Anant713/Antenna-Deployment-System/Mod4_1.step

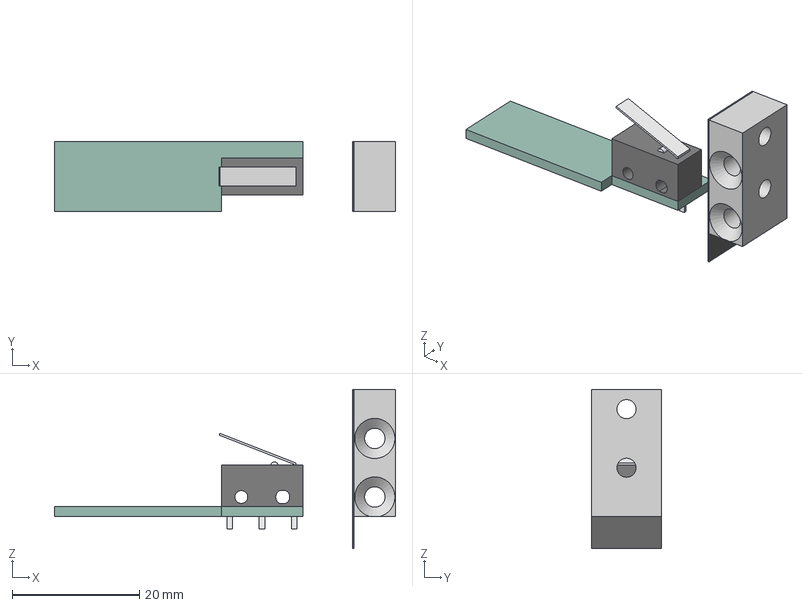
[picture p1: CAD file, 2026-06-16]
Mod4_1.step
53.6 x 11.0 x 25.0 mm
Mod4p3
Copperfoil^Mod4
d2f-01l
Part1^Mod4
