Anant713/Antenna-Deployment-System/Resistor_board/.step

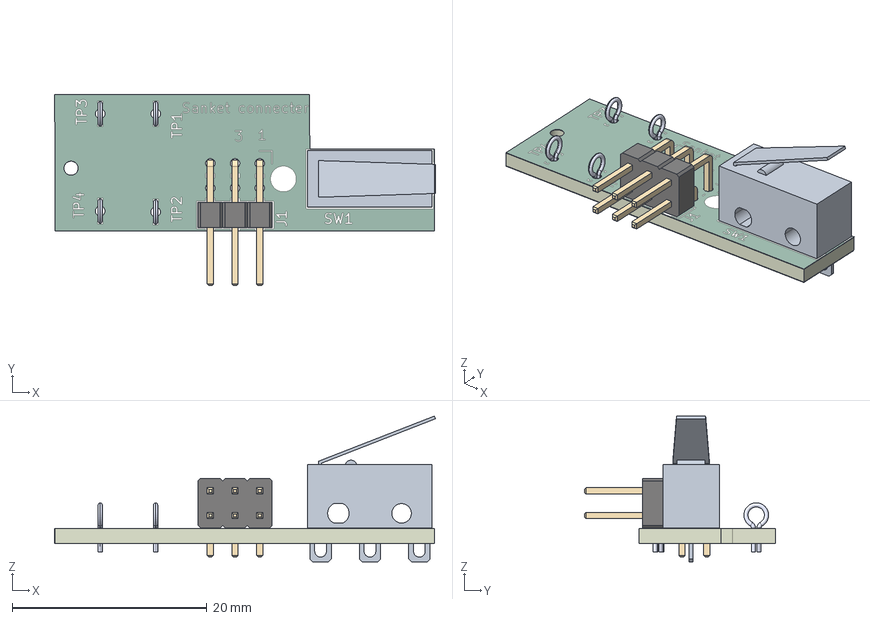
[picture p2: CAD file, 2026-05-25]
Resistor_board/.step
39.2 x 19.7 x 15.0 mm
D2F_01FL_D3.BASE
D2F_01FL_D3.ACTUATOR
PinHeader_2x03_P254mm_Horizontal
Resistor_board_silkscreen x 2
Resistor_board_soldermask x 2
Resistor_board_PCB
