Anant713/Antenna-Deployment-System/Resistor_board_nichrome/resistor_board_nichrome.step

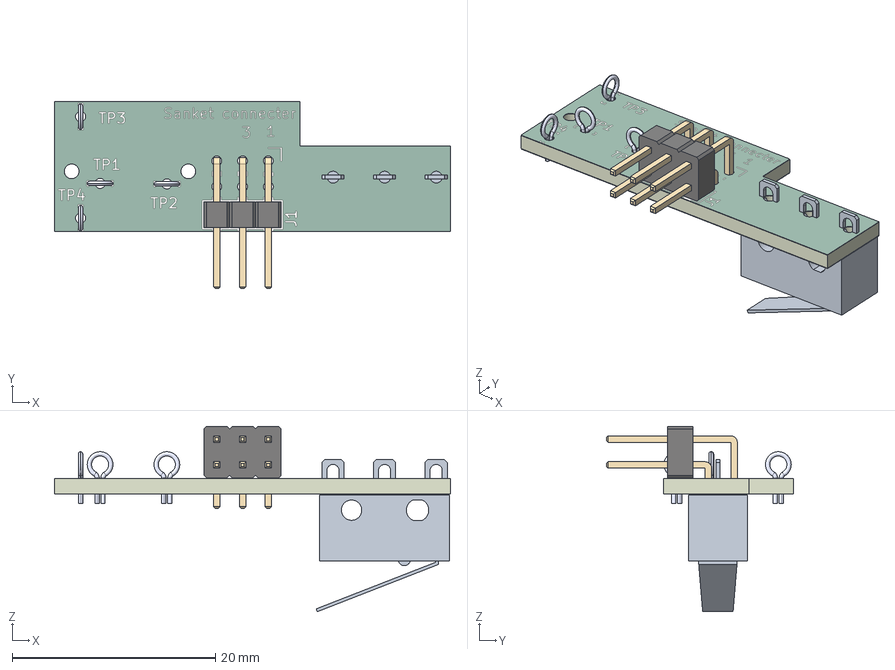
[picture p3: CAD file, 2026-06-17]
Resistor_board_nichrome/resistor_board_nichrome.step
39.0 x 18.4 x 18.3 mm
PinHeader_2x03_P254mm_Horizontal
D2F_01FL_D3.BASE
D2F_01FL_D3.ACTUATOR
Resistor_board_silkscreen x 2
Resistor_board_soldermask x 2
Resistor_board_PCB
