Anant713/Antenna-Deployment-System/Sanket_Deployment_board/ADS_V8.step

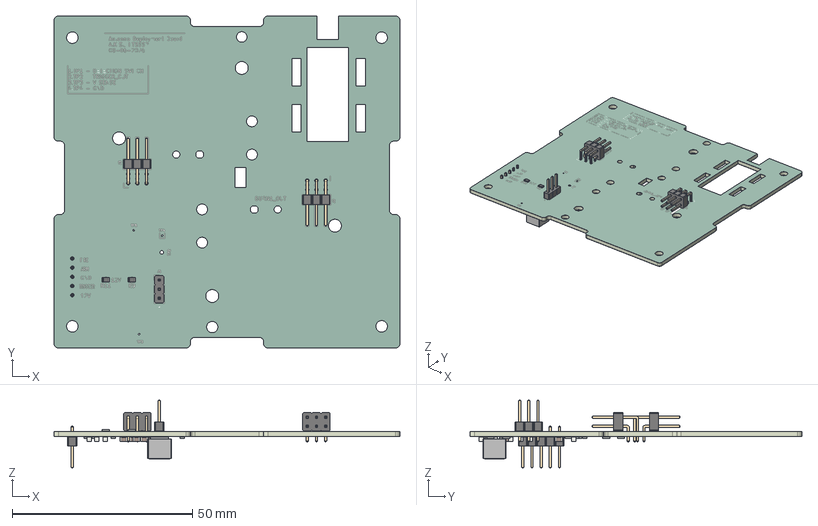
[picture p4: CAD file, 2026-06-16]
Sanket_Deployment_board/ADS_V8.step
95.9 x 92.0 x 18.8 mm
R_0805_2012Metric x 12
PinHeader_1x03_P254mm_Vertical
PinHeader_2x03_P254mm_Horizontal x 2
C_0805_2012Metric x 11
PinHeader_1x05_P254mm_Vertical
L_Wurth_WE-XHMI-6060P
sanket_silkscreen x 2
sanket_soldermask x 2
sanket_PCB
