Anant713/Antenna-Deployment-System/Sanket_Deployment_board/Ref_PCB.dxf

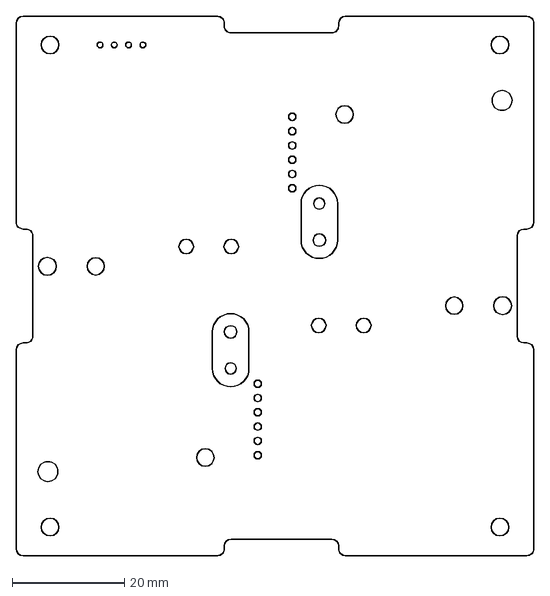
[picture p5: CAD file, 2026-05-25]
Sanket_Deployment_board/Ref_PCB.dxf
92.0 x 95.9 mm
