Anant713/Antenna-Deployment-System/APOD_PCB.dxf

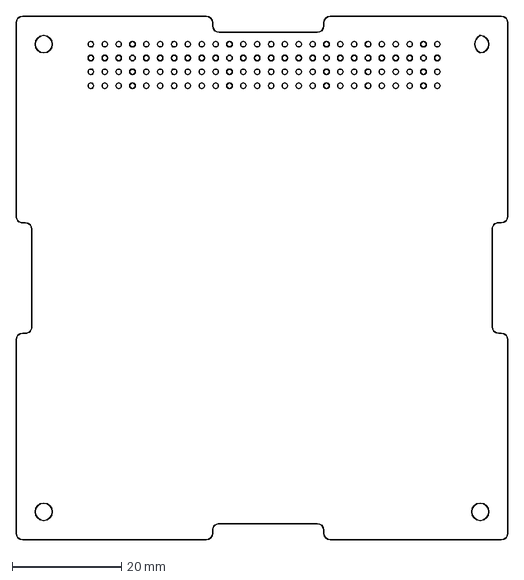
[picture p6: CAD file, 2026-06-09]
APOD_PCB.dxf
90.2 x 95.9 mm
