Anant713/Antenna-Deployment-System/(list of files, cad)

Other CAD files:
Resistor_board_resistor/resistor_board_resistor.step
Mod4_2.step
