Anant713/Antenna-Deployment-System/Sanket_Deployment_board/schematic.pdf

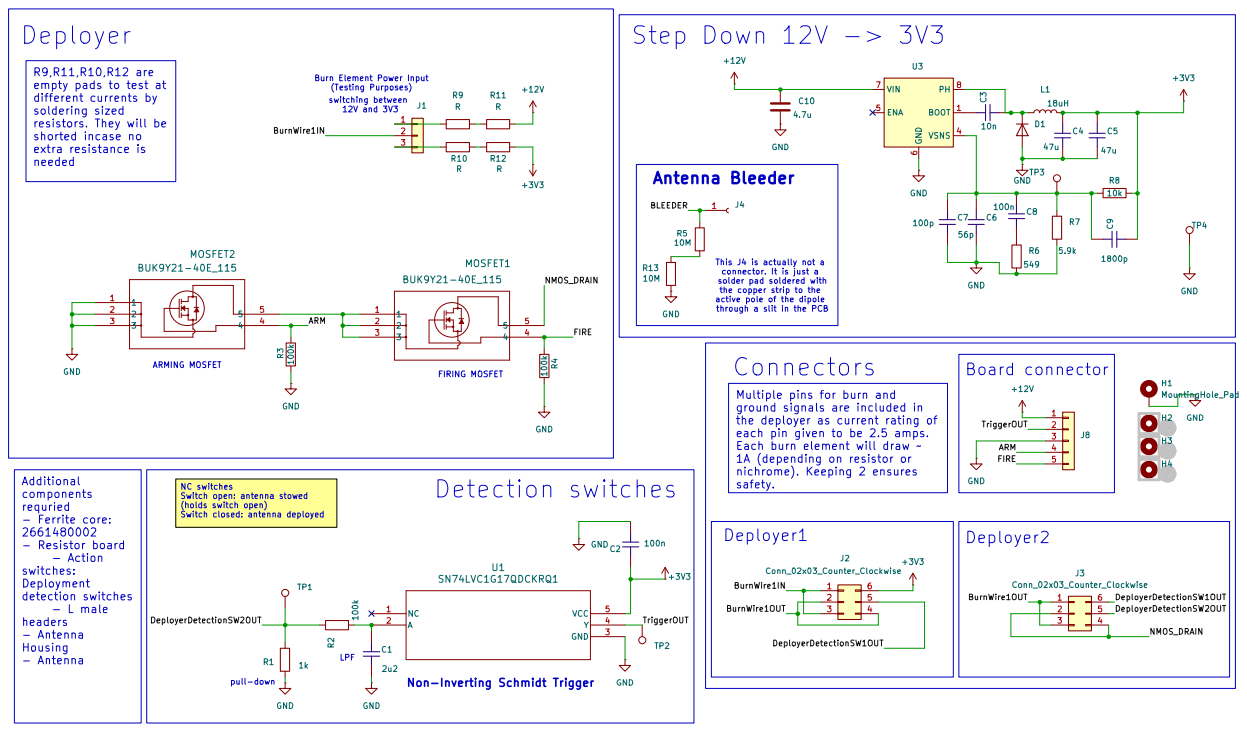
[picture p8: page 1]
