Anant713/Antenna-Deployment-System/Sanket_Deployment_board/sanket.kicad_pcb

## KiCad design Sanket_Deployment_board/sanket.kicad_pcb (2026-07-09)

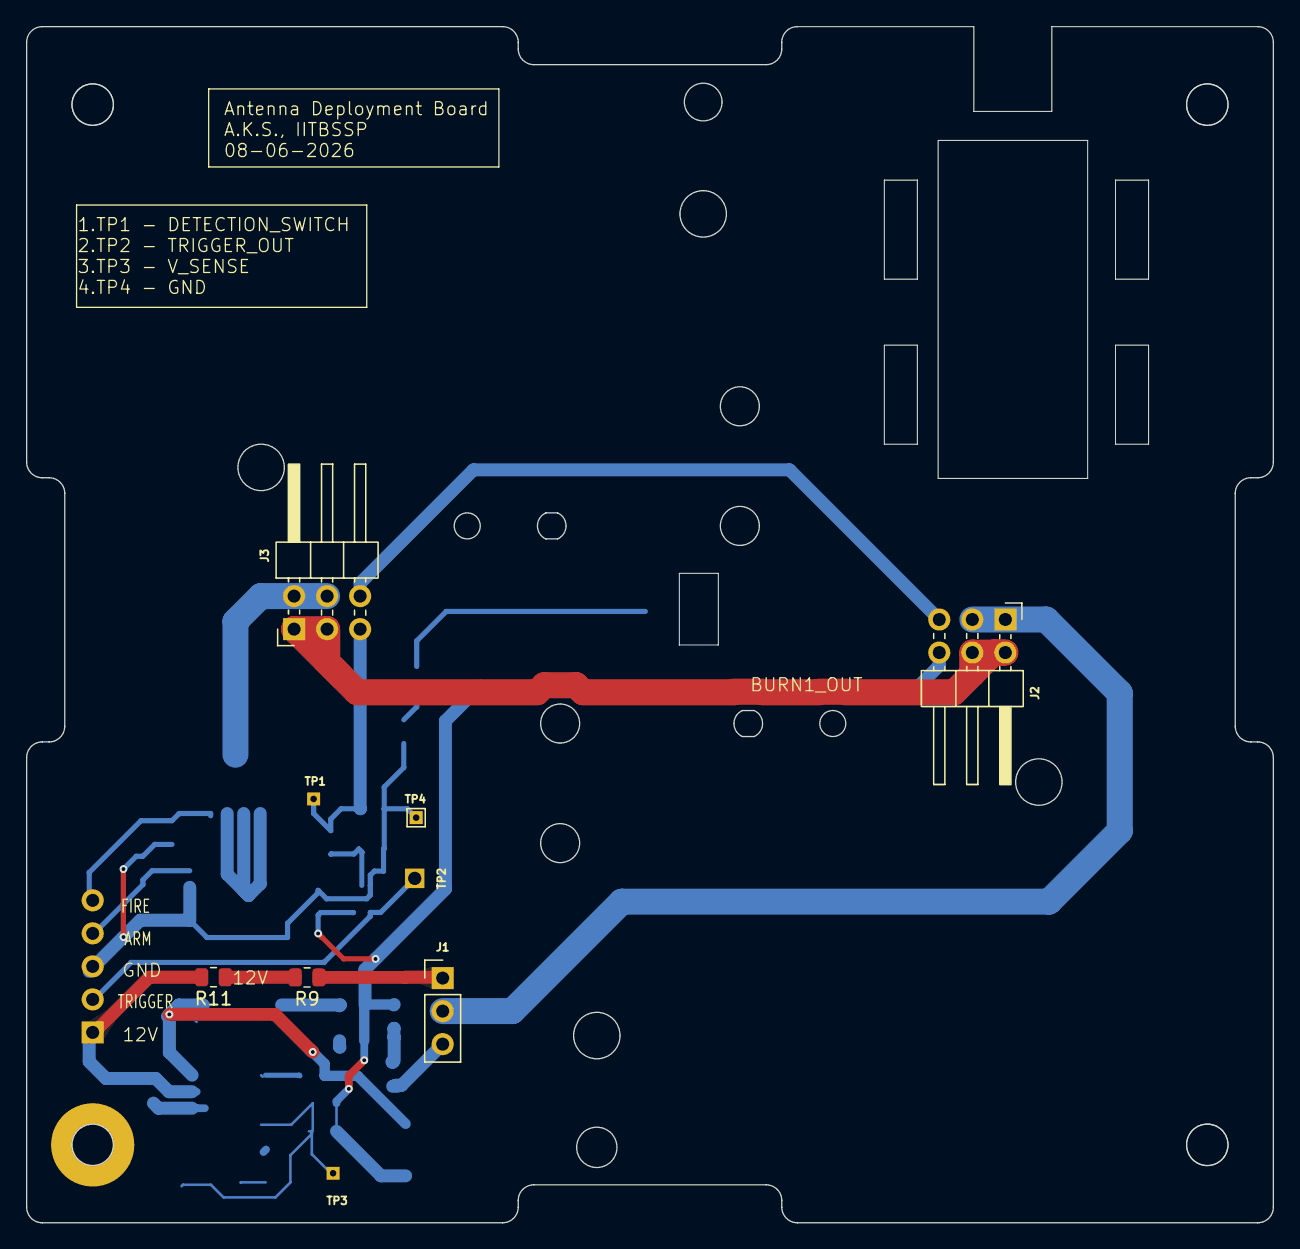
[picture p9: board sanket.kicad_pcb from above]

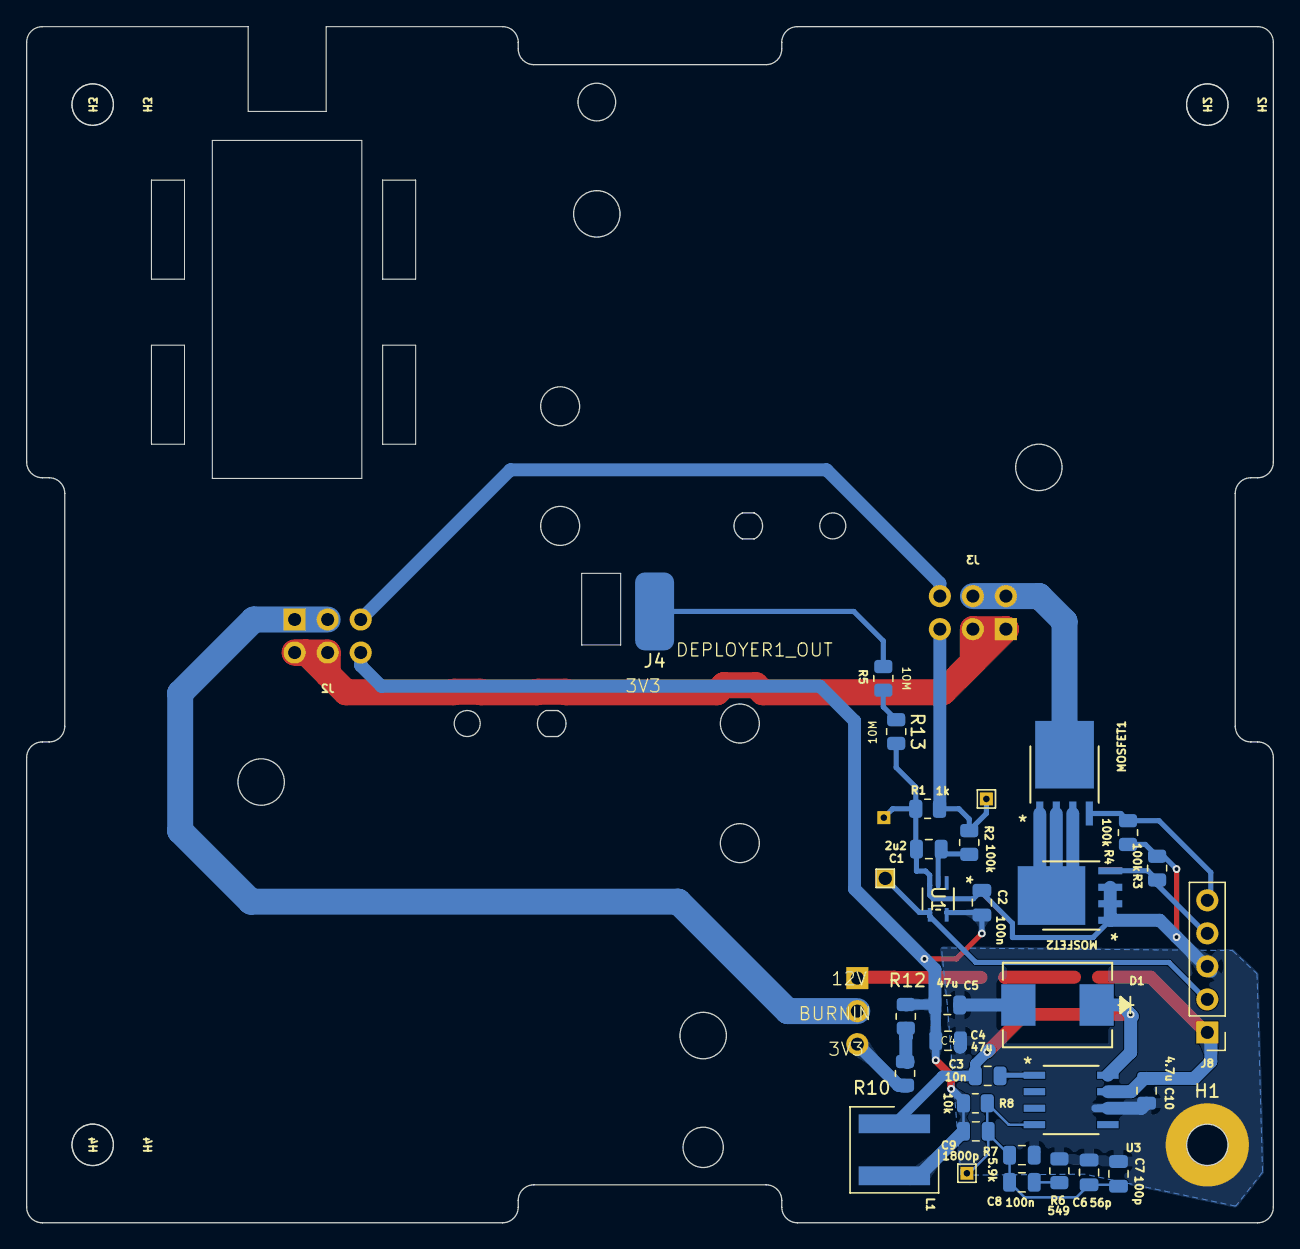
[picture p10: board sanket.kicad_pcb from below]

Board: 2 copper layers, 95.9 x 92.0 mm, 42 parts (32 on the bottom side), 23 nets.

Parts:
C1: 2u2; C_0805_2012Metric
C2, C8: 100n; C_0805_2012Metric
C3: 10n; C_0805_2012Metric
C4, C5: 47u; C_0805_2012Metric
C6: 56p; C_0805_2012Metric
C7: 100p; C_0805_2012Metric
C9: 1800p; C_0805_2012Metric
C10: 4.7u; C_0805_2012Metric
D1: CR_MBRS340_ONS-M
H1: MountingHole_Pad; MountingHole_3.2mm_M3_Pad
H2, H3, H4: MountingHole_3.2mm_M3
J1: PinHeader_1x03_P2.54mm_Vertical
J2, J3: Conn_02x03_Counter_Clockwise; PinHeader_2x03_P2.54mm_Horizontal
J4: SolderWirePad_1x01_SMD_3x6mm
J8: PinHeader_1x05_P2.54mm_Vertical
L1: 18uH; L_Wurth_WE-XHMI-6060P
MOSFET1, MOSFET2: BUK9Y21-40E_115; LFPAK56_SOT669_NEX-M
R1: 1k; R_0805_2012Metric
R2, R3, R4: 100k; R_0805_2012Metric
R5, R13: 10M; R_0805_2012Metric
R6: 549; R_0805_2012Metric
R7: 5.9k; C_0805_2012Metric
R8: 10k; R_0805_2012Metric
R9, R10, R11, R12: R; R_0805_2012Metric
TP1, TP2, TP3, TP4: TestPoint_THTPad_1.0x1.0mm_Drill0.5mm
U1: SN74LVC1G17QDCKRQ1; DCK5-M
U3: D8-M

Connections:
+3V3: C2.2, C4.2, C5.2, C9.1, J2.6, L1.2, R8.1, R12.1, U1.5 (VCC)
+12V: C10.1, J8.1, R11.2, U3.7 (VIN)
/ARM: J8.4, MOSFET2.4, R3.1
/BLEEDER: J4.1 (Pin_1_1), R5.1
/BurnWire1IN: J1.2, J2.1, J2.3
/BurnWire1OUT: J2.2, J2.4, J3.1, J3.3
/DeployerDetectionSW1OUT: J2.5, J3.6
/DeployerDetectionSW2OUT: J3.5, R1.1, R2.1, TP1.1 (1_1)
/FIRE: J8.5, MOSFET1.4, R4.1
/NMOS_DRAIN: J3.2, J3.4, MOSFET1.5
/TriggerOUT: J8.2, TP2.1 (1_1), U1.4 (Y)
GND: C1.1, C2.1, C4.1, C5.1, C6.1, C7.1, C10.2, D1.2 (A), H1.1 (1_1), J8.3, MOSFET2.1, MOSFET2.2, MOSFET2.3, R1.2, R3.2, R4.2, R6.2, R7.2, R13.2, TP4.1 (1_1), U1.3 (GND), U3.6 (GND)
unnamed: C8.1, R6.1
unnamed: C3.1, D1.1 (K), L1.1, U3.8 (PH)
unnamed: J1.1, R9.1
unnamed: J1.3, R10.1
unnamed: MOSFET1.1, MOSFET1.2, MOSFET1.3, MOSFET2.5
unnamed: R10.2, R12.2
unnamed: R9.2, R11.1
unnamed: R5.2, R13.1
unnamed: C1.2, R2.2, U1.2 (A)
unnamed: C3.2, U3.1 (BOOT)
unnamed: C6.2, C7.2, C8.2, C9.2, R7.1, R8.2, TP3.1 (1_1), U3.4 (VSNS)
