Anant713/Antenna-Deployment-System/Resistor_board_nichrome/Resistor_board.kicad_pcb

## KiCad design Resistor_board_nichrome/Resistor_board.kicad_pcb (2026-06-20)

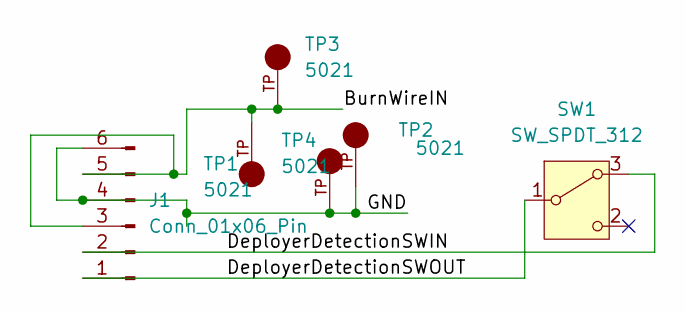
[picture p11: schematic Resistor_board.kicad_sch]

Parts:
J1: Conn_01x06_Pin; PinHeader_2x03_P2.54mm_Horizontal
SW1: SW_SPDT_312; D2F-L_OMR
TP1, TP2, TP3, TP4: 5021; TP_5021; PARTREV B

Connections:
/BurnWireIN: J1.3, J1.5, TP1.TP, TP3.TP
/DeployerDetectionSWIN: J1.2, SW1.3 (A)
/DeployerDetectionSWOUT: J1.1, SW1.1 (B)
/GND: J1.4, J1.6, TP2.TP, TP4.TP

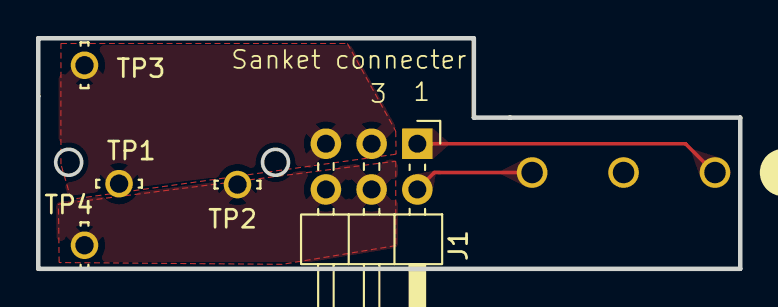
[picture p12: board Resistor_board.kicad_pcb from above]

Board: 2 copper layers, 39.0 x 12.8 mm, 6 parts (1 on the bottom side), 4 nets.
