Anant713/Antenna-Deployment-System/(commit log)

2026-05-25 Resistor board completed. Main board schematic completed and footprints assigned
    [FinalBOM.csv, Ref_PCB.dxf, Resistor_board.csv, Resistor_board.kicad_pcb, Resistor_board.kicad_sch, Sanket.step, TPS54x40_AND_TPS54x60_CALCTOOL_v1p1.xls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]
2026-05-25 Switch footprint flipped to opposite side, Edgecut layer updated according to new resistor board
    [.step, ADS_DXF_mainboard_withRB.dxf, ADS_mainboard.dxf, Resistor_board.kicad_pcb, resistor_board.step, sanket.kicad_pcb]
2026-05-26 Routing done, 1st review to be done
    [ADS_v1.step, sanket.kicad_pcb, sanket.kicad_sch]
2026-05-27 Added missing holw in resistor board, removed NAND gate, added more testpoints
    [Resistor_board.kicad_pcb, sanket.kicad_pcb, sanket.kicad_sch]
2026-05-28 Added extra pads for sized resistors
    [sanket.kicad_pcb, sanket.kicad_sch]
2026-05-29 Resistor board for nichrome added
    [.step, Resistor_board.csv, Resistor_board.kicad_pcb, Resistor_board.kicad_sch, resistor_board.step, sanket.kicad_pcb, sanket.kicad_sch]
2026-06-05 Added antenna bleeder, switched FIRE and ARM with each other, Corrected Schmitt trigger symbol to non-inverting
    [ADS_DXF_mainboard_withRB.dxf, ADS_mainboard.dxf, FinalBOM.csv, TPS54x40_AND_TPS54x60_CALCTOOL_v1p1.xls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]
2026-06-08 Replace a mounting hole to mounting pad to ground
    [sanket.kicad_pcb, sanket.kicad_sch]
2026-06-08 Added schematic pdf of Sanket
    [sanket.kicad_pcb]
2026-06-09 Aligned holes according to PC104, flipped header used to choose burn power, corrected silkscreen
    [APOD_PCB.dxf, sanket.kicad_pcb]
2026-06-16 Added step file for ADS_V8
    [ADS_V8.step, ADS_v1.step, Mod4_1.step, Mod4_2.step, Resistor_board.kicad_pcb, resistor_board.step, sanket.kicad_pcb]
2026-06-17 Cahnges dimensions of resistor boards due to clash with housing
    [ADS_V8.step, Resistor_board.kicad_pcb, resistor_board.step, resistor_board_nichrome.step, resistor_board_resistor.step]
2026-06-20 Added gerber and drill files , default settings completely
    [Resistor_board-B_Cu.gbr, Resistor_board-B_Mask.gbr, Resistor_board-B_Paste.gbr, Resistor_board-B_Silkscreen.gbr, Resistor_board-Edge_Cuts.gbr, Resistor_board-F_Cu.gbr, Resistor_board-F_Mask.gbr, Resistor_board-F_Paste.gbr]
2026-07-09 In the main board, branching power at 3V3 to burn elements after decoupling capacitors, power trace branched earlier before
    [sanket.kicad_pcb]
